AlexGyver/ALight_by_KARMAN/Preview.jpg

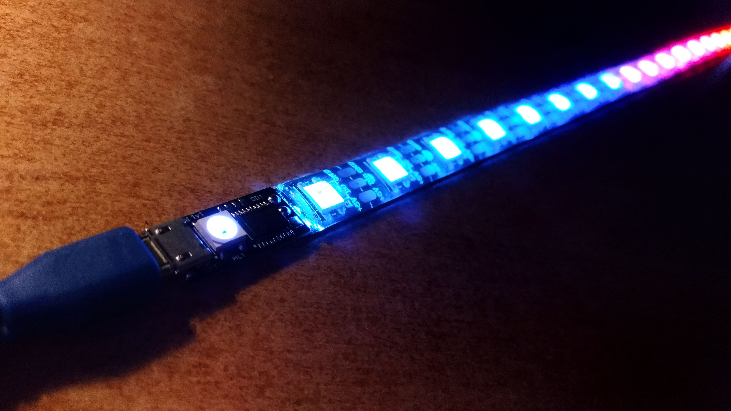
Preview.jpg
