AlexGyver/ALight_by_KARMAN/Изображения [jpeg]/4_Color.jpg

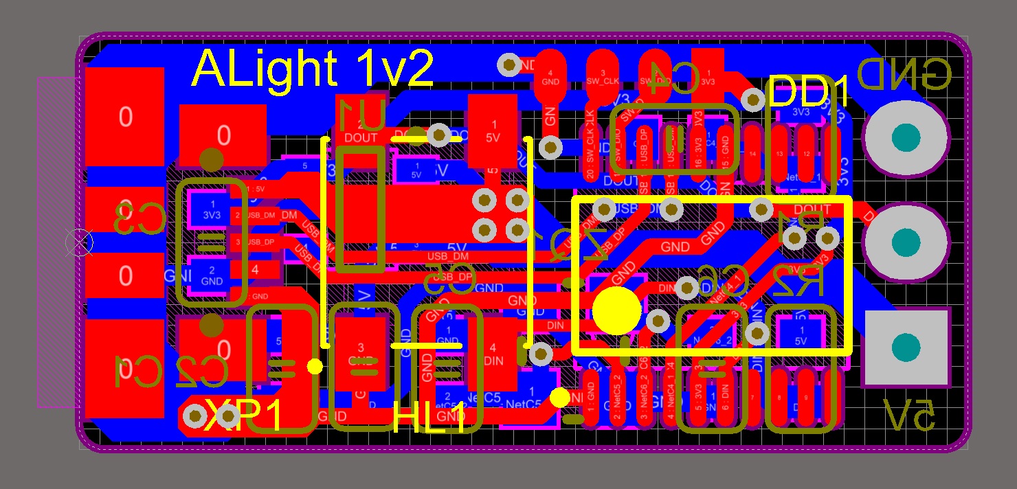
Изображения [jpeg]/4_Color.jpg
