AlexGyver/ALight_by_KARMAN/README.md

# ALight_by_KARMAN
 Компактный Ambilight на STM32
