AlexGyver/ALight_by_KARMAN/Изображения [jpeg]/1_Scheme.jpg

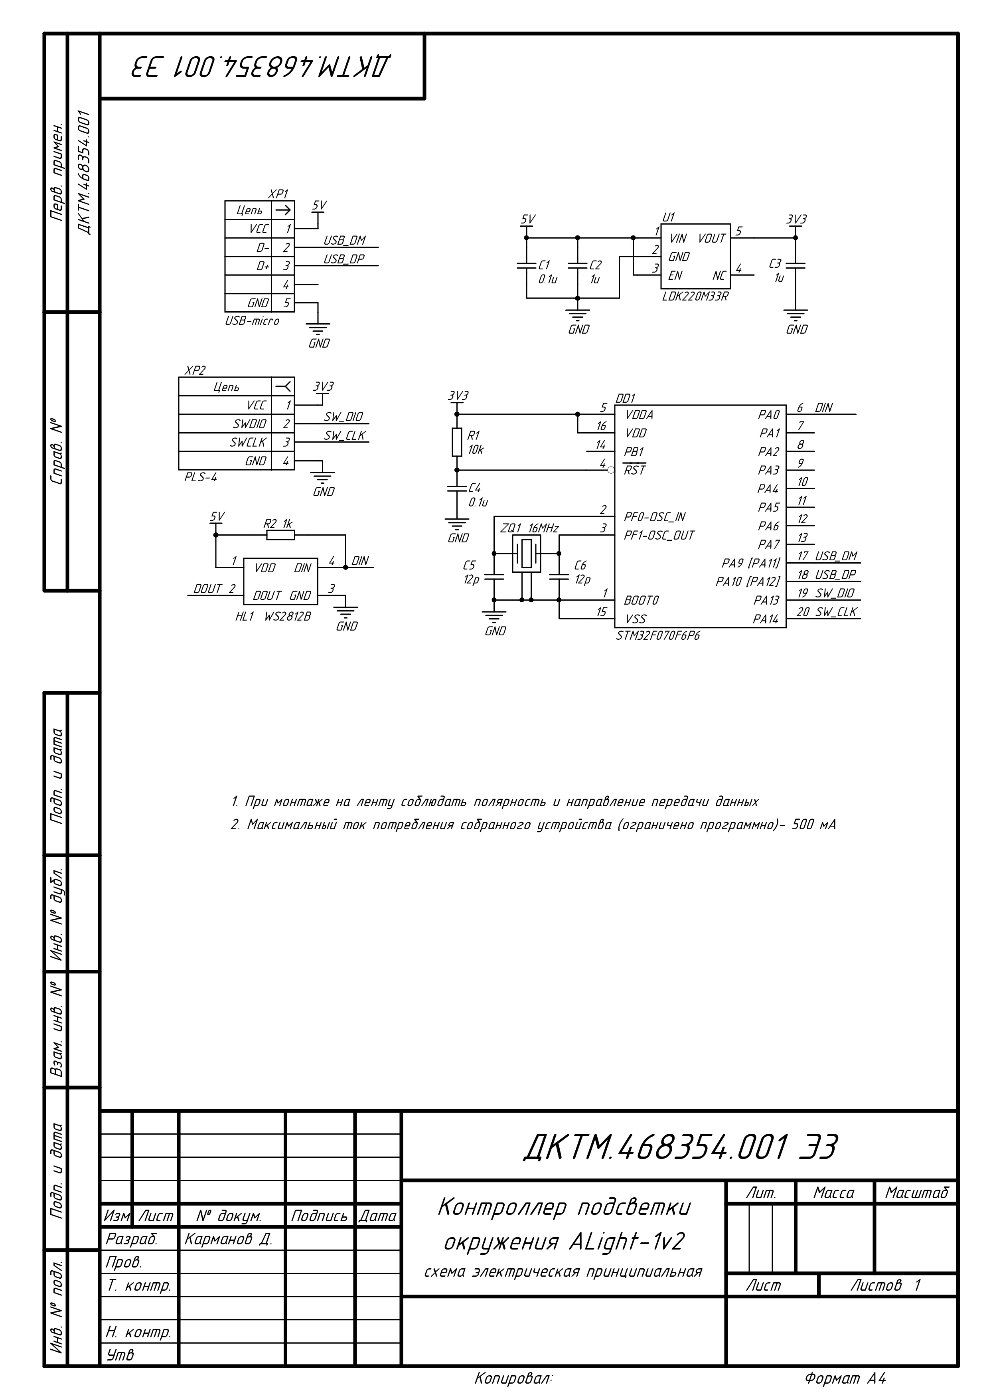
Изображения [jpeg]/1_Scheme.jpg
