AlexGyver/ALight_by_KARMAN/Изображения [jpeg]/2_Top.jpg

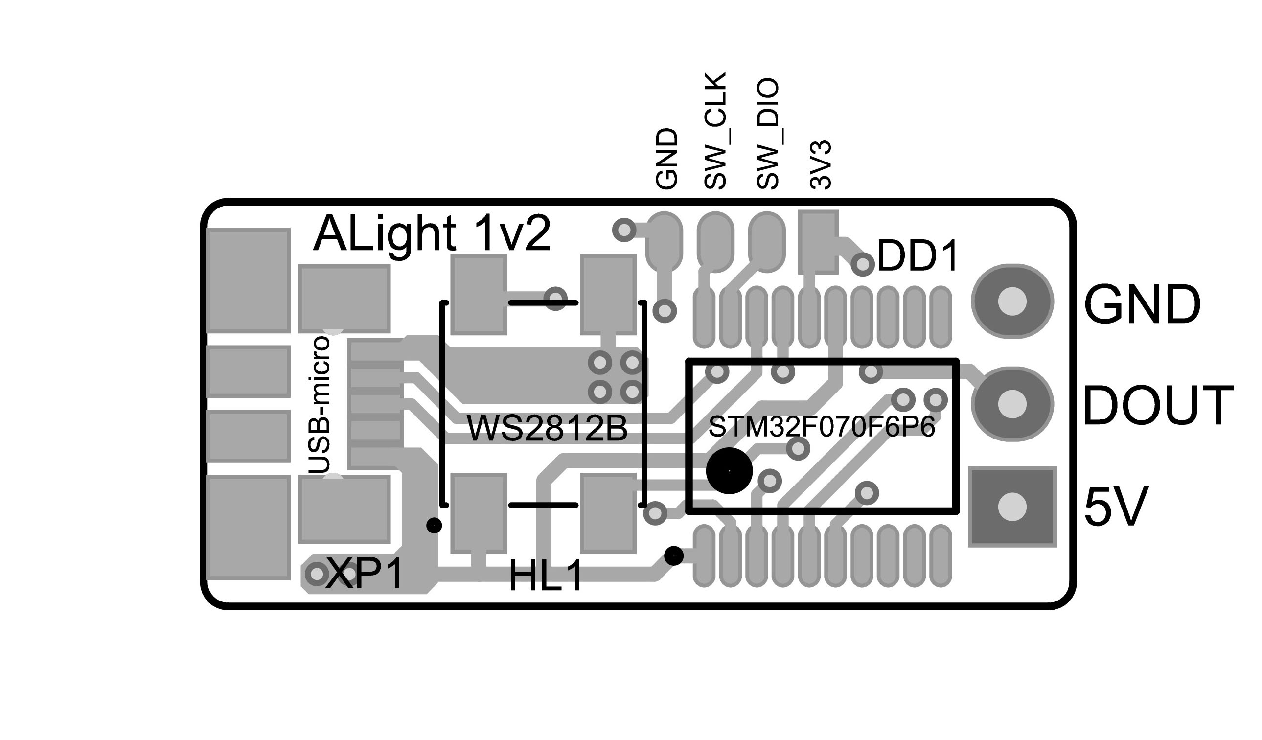
Изображения [jpeg]/2_Top.jpg
