AlexGyver/ALight_by_KARMAN/Изображения [jpeg]/3_Bottom.jpg

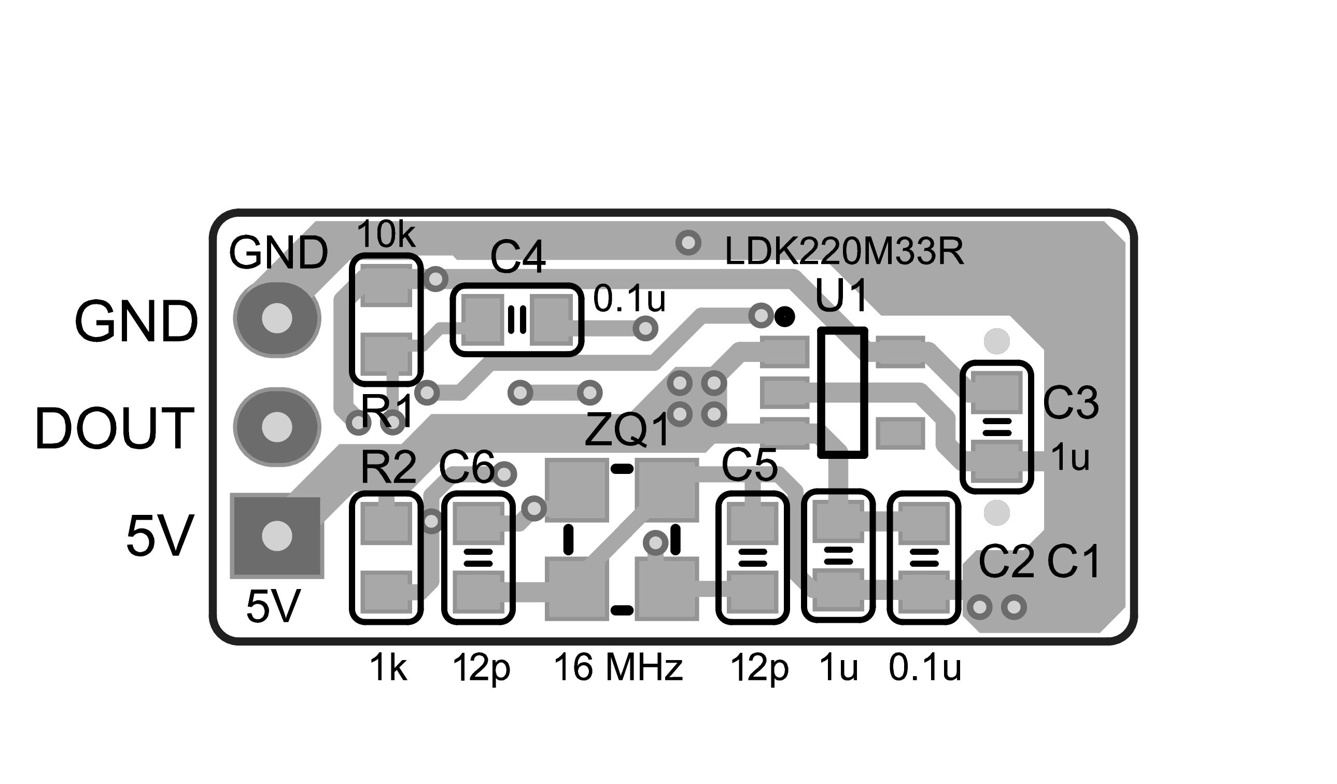
Изображения [jpeg]/3_Bottom.jpg
