AlexGyver/ALight_by_KARMAN/Изображения [jpeg]/5_Photo.jpg

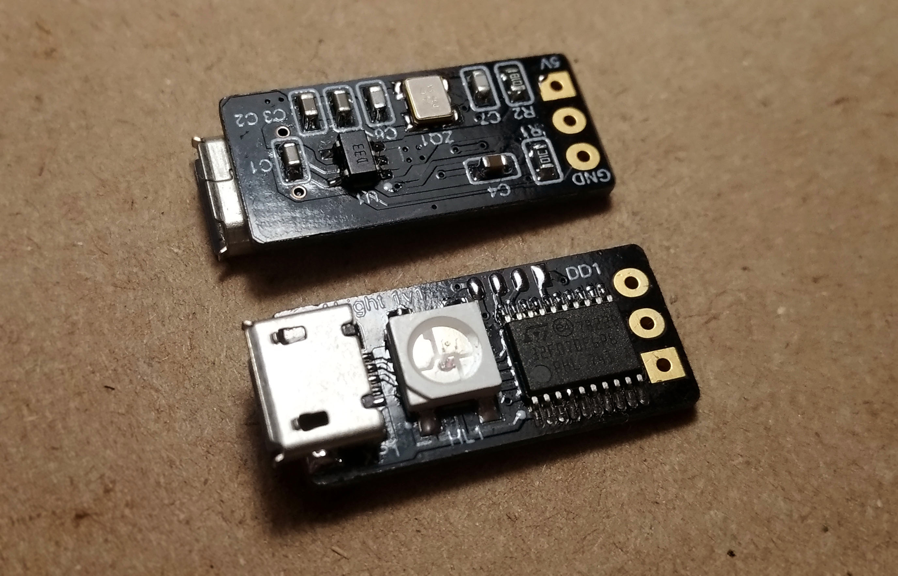
Изображения [jpeg]/5_Photo.jpg
