AlexGyver/ALight_by_KARMAN/Изображения [jpeg]/6_Photo.jpg

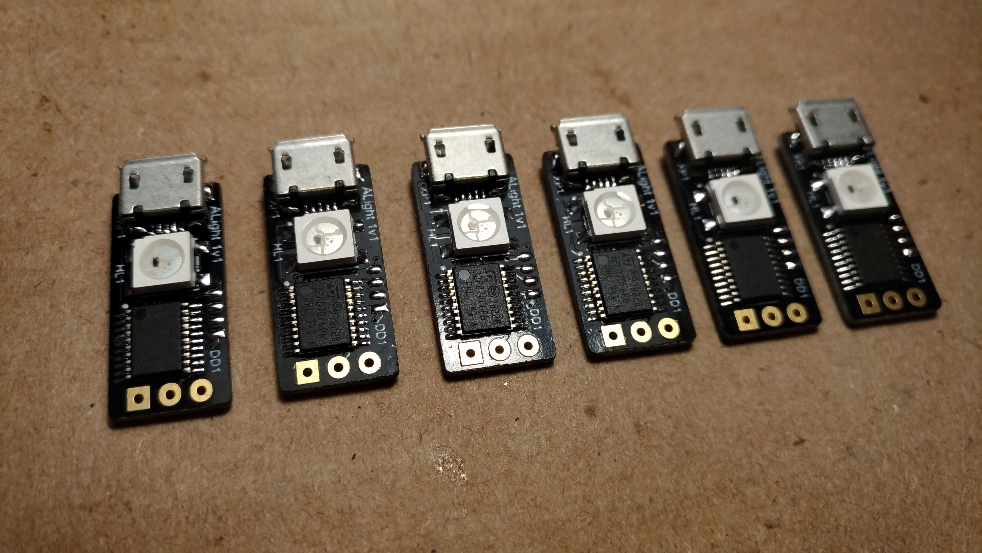
Изображения [jpeg]/6_Photo.jpg
