AlexGyver/ALight_by_KARMAN/Производство [gerb+bom]/ALight-1v2_BOM.xls

Позиционное обозначение | Корпус | Наименование | Ссылка | Срок поставки | Кол-во | Цена | Сумма
C1, C4 | SMD 0603 | CC0603KRX7R8BB104 | https://www.terraelectronica.ru/product/326943 | 1 день | 2 | 0.57 | 1.14
C2, C3 | SMD 0603 | CC0603KRX5R6BB105 | https://www.terraelectronica.ru/product/675328 | 1 день | 2 | 0.81 | 1.62
C5, C6 | SMD 0603 | CC0603JRNPO9BN120 | https://www.terraelectronica.ru/product/326938 | 1 день | 2 | 0.34 | 0.68
DD1 | TSSOP-20 | STM32F070F6P6 | https://www.terraelectronica.ru/product/1899767 | 1 день | 1 | 63.5 | 63.5
HL1 | SMD 5050 | WS2812B | https://www.chipdip.ru/product/ws2812b | 1 день | 1 | 12.1 | 12.1
R1 | SMD 0603 | RC0603FR-0710KL | https://www.terraelectronica.ru/product/561050 | 1 день | 1 | 0.14 | 0.14
R2 | SMD 0603 | RC0603FR-071KL | https://www.terraelectronica.ru/product/542464 | 1 день | 1 | 0.14 | 0.14
U1 | SOT23-5 | LDK220M33R | https://www.terraelectronica.ru/product/1318011 | 1 день | 1 | 10.3 | 10.3
XP1 | USB-micro | 473460001 | https://www.terraelectronica.ru/catalog/razemy-usb-1554?text=473460001&search=473460001 | 1 день | 1 | 37.4 | 37.4
ZQ2 | SMD03225C4 | KX-7 16.0 MHz | https://www.terraelectronica.ru/product/165772 | 1 день | 1 | 21 | 21
 |  |  |  |  |  |  | 148.02
