AlexGyver/ALight_by_KARMAN/(list of files, drawings)

Other design files:
Проект [altium]/ALight.PcbDoc
Проект [altium]/ALight.PrjPcb
Проект [altium]/ALight.SchDoc
