AlexGyver/ALight_by_KARMAN/Прошивка [sw4stm32]/Project/Src/main.c

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

/* Includes ------------------------------------------------------------------*/
#include "main.h"
#include "usb_device.h"

TIM_HandleTypeDef htim1;

void SystemClock_Config(void);
static void MX_GPIO_Init(void);
static void MX_TIM1_Init(void);
/* USER CODE BEGIN 0 */
#include "flash.h"

float light = 0.1;
uint32_t MSled[255];
uint32_t led_num = 0;
uint32_t led_fl= 0;
uint32_t led_cur = 0;
uint32_t tim1=0;
uint8_t frx=0;
uint8_t fok=1;
uint8_t fstart=0;


void LED_set(uint32_t *ms, uint32_t ln)
{
	 __disable_irq();
	for(uint8_t n=0; n<ln; n++)
	{
		for(int32_t b = 23; b>=0; b--)
		{
			if(ms[n] & (1<<b))
			{
				GPIOA->ODR |= 0x1;
				asm volatile ("nop; nop; nop; nop; nop; nop; nop; nop; nop; nop; nop; nop; nop; nop; nop; nop; nop; nop; nop; nop; nop; nop; nop; nop; nop; nop; nop; nop; nop; nop; nop; nop;");
				GPIOA->ODR &=~ 0x1;
				asm volatile ("nop; nop; nop; nop;");
			}
			else
			{
				GPIOA->ODR |= 0x1;
				asm volatile ("nop; nop; nop; nop; nop; nop; nop; nop; nop; nop; nop; nop; nop; nop; nop; nop; nop;");
				GPIOA->ODR &=~ 0x1;
				asm volatile ("nop; nop; nop; nop; nop; nop; nop; nop; nop; nop; nop; nop; nop; nop; nop; nop; nop;");
			}
		}
	}
	__enable_irq();
}

/* USER CODE END 0 */

/**
  * @brief  The application entry point.
  * @retval int
  */
int main(void)
{
  

  /* MCU Configuration--------------------------------------------------------*/

  /* Reset of all peripherals, Initializes the Flash interface and the Systick. */
  HAL_Init();

  /* Configure the system clock */
  SystemClock_Config();

  /* Initialize all configured peripherals */
  MX_GPIO_Init();
  MX_TIM1_Init();
  MX_USB_DEVICE_Init();
  /* USER CODE BEGIN 2 */

    flash_unlock();
  	led_num = flash_read(0x08007C00);

  	if(led_num>254) led_num = 30;

  	float clr_r, clr_b;
  	light = 500.0/(24.0*led_num);
  	if(light>1) light=1;

    for(uint8_t i=0; i<led_num; i++)
    {
    	clr_r = 255.0*(led_num-i)/led_num;
    	clr_b = 255.0*i/led_num;

    	uint8_t buf_r = light*clr_r;
    	uint8_t buf_b = light*clr_b;

    	if(0)																	// Выбор визуализации старта
    	{
    		for(uint8_t j=0; j<=i; j++)
    			MSled[j]=buf_r*0x100 + buf_b;
    	}
    		else
    			MSled[i]=buf_r*0x100 + buf_b;

    			MSled[0]=buf_r*0x100 + buf_b;


    	LED_set(MSled,  led_num);
    	HAL_Delay(700/led_num);
    }

    HAL_Delay(300);
    led_fl = led_num;

    for(uint8_t i=0; i<led_num; i++) MSled[i]=0x0;
    LED_set(MSled,  led_num);

  	HAL_TIM_Base_Start(&htim1);
    HAL_TIM_Base_Start_IT(&htim1);

    fstart=1;

  /* USER CODE END 2 */

  /* Infinite loop */
  /* USER CODE BEGIN WHILE */
  while (1)
  {
	  if(fok)
	  {
		  LED_set(MSled, led_num);
		  fok=0;
	  }
	  HAL_Delay(1);

	  if(led_num != led_fl)
	  {
		  flash_erase_page(0x08007C00);
		  flash_write(0x08007C00, led_num);
		  led_fl = led_num;
	  }
    /* USER CODE END WHILE */

    /* USER CODE BEGIN 3 */
  }
  /* USER CODE END 3 */
}

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
