AlexGyver/ALight_by_KARMAN/Прошивка [sw4stm32]/Project/ALight.ioc

Mcu.UserName=STM32F070F6Px
PA0.Signal=GPIO_Output
PA11.Signal=USB_DM
PA12.Signal=USB_DP
PA13.Signal=SYS_SWDIO
PA14.Signal=SYS_SWCLK
PA4.Signal=GPIO_Output
PF0-OSC_IN.Signal=RCC_OSC_IN
PF1-OSC_OUT.Signal=RCC_OSC_OUT
