AlexGyver/ALight_by_KARMAN/(notices)

Notices in the files:
Прошивка [sw4stm32]/Project/Src/main.c:
© Copyright (c) 2019 STMicroelectronics.
All rights reserved.
This software component is licensed by ST under Ultimate Liberty license
(C) COPYRIGHT STMicroelectronics *****END OF FILE
